vincentchen18/chess-clock/BOM.csv

Part | Qty | Unit price (USD) | Vendor | Link
HT16K33A-28SOP LED driver | 1 | 0.7531 | LCSC | https://www.lcsc.com/product-detail/C5444737.html
FJ3461AH 0.36in 4-digit 7-seg common cathode | 2 | 0.6709 | LCSC | https://www.lcsc.com/product-detail/C10708.html
100nF 0805 capacitor | 20 | 0.0206 | LCSC | https://www.lcsc.com/product-detail/C49678.html
10uF 0805 capacitor | 20 | 0.0441 | LCSC | https://www.lcsc.com/product-detail/C15850.html
PCM12SMTR slide switch | 1 | 1.2754 | LCSC | https://www.lcsc.com/product-detail/C221841.html
JST S2B-PH-SM4-TB battery connector | 5 | 0.2288 | LCSC | https://www.lcsc.com/product-detail/C295747.html
GPC12075YB-5V passive piezo buzzer | 1 | 0.5624 | LCSC | https://www.lcsc.com/product-detail/C252948.html
6x6x11mm tactile switch THT | 10 | 0.039 | LCSC | https://www.lcsc.com/product-detail/C720305.html
12x12x7.3mm tactile switch THT | 10 | 0.0662 | LCSC | https://www.lcsc.com/product-detail/C231717.html
Seeed XIAO ESP32-C3 | 1 | 0.97 | AliExpress
LiPo 503450 3.7V 1000mAh JST PH2.0 | 1 | 6.45 | AliExpress | https://www.aliexpress.com/item/1005012823920013.html
Chess clock PCB 80x95mm 2-layer | 5 | 0.80 | JLCPCB | https://jlcpcb.com
220k resistor 1/4W THT | 2 | 0.00 | Owned (resistor kit)
4.7k resistor 1/4W THT | 2 | 0.00 | Owned (resistor kit)
100 ohm resistor 1/4W THT | 1 | 0.00 | Owned (resistor kit)
