vincentchen18/chess-clock/3D Models/Printing Assembly.stl

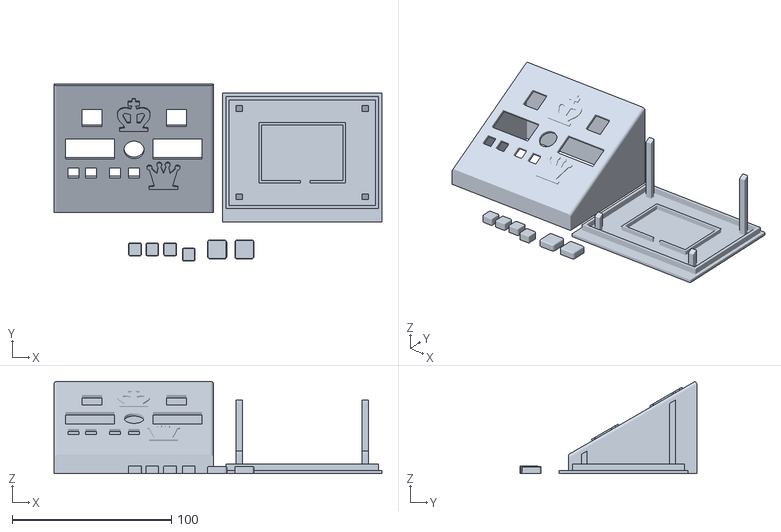
[picture p6: CAD file, 2026-10-31]
3D Models/Printing Assembly.stl
205.7 x 111.0 x 58.0
