vincentchen18/chess-clock/Kicad Files/Kicad Files.step

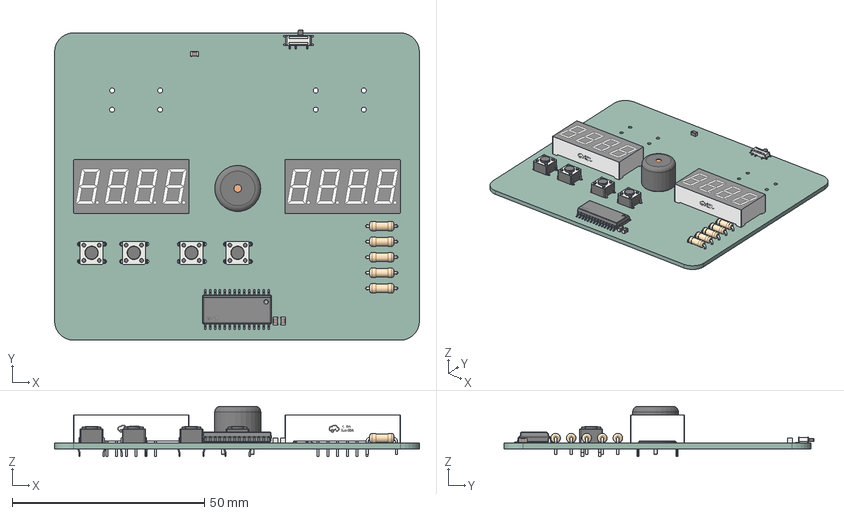
[picture p7: CAD file, 2026-10-27]
Kicad Files/Kicad Files.step
95.0 x 80.8 x 13.1 mm
R_Axial_DIN0207_L63mm_D25mm_P762mm_Horizontal x 5
Buzzer_12x95RM76
SW_PUSH_6mm x 4
C_0805_2012Metric x 3
LED-SEG-TH_0.36-4P x 2
SOP-28_L17.9-W7.5-P1.27-LS10.3-BL
Fusion_sp
Kicad Files_PCB
