vincentchen18/chess-clock/Kicad Files/Kicad Files.kicad_pcb

## KiCad design Kicad Files/Kicad Files.kicad_pcb (2026-11-01)

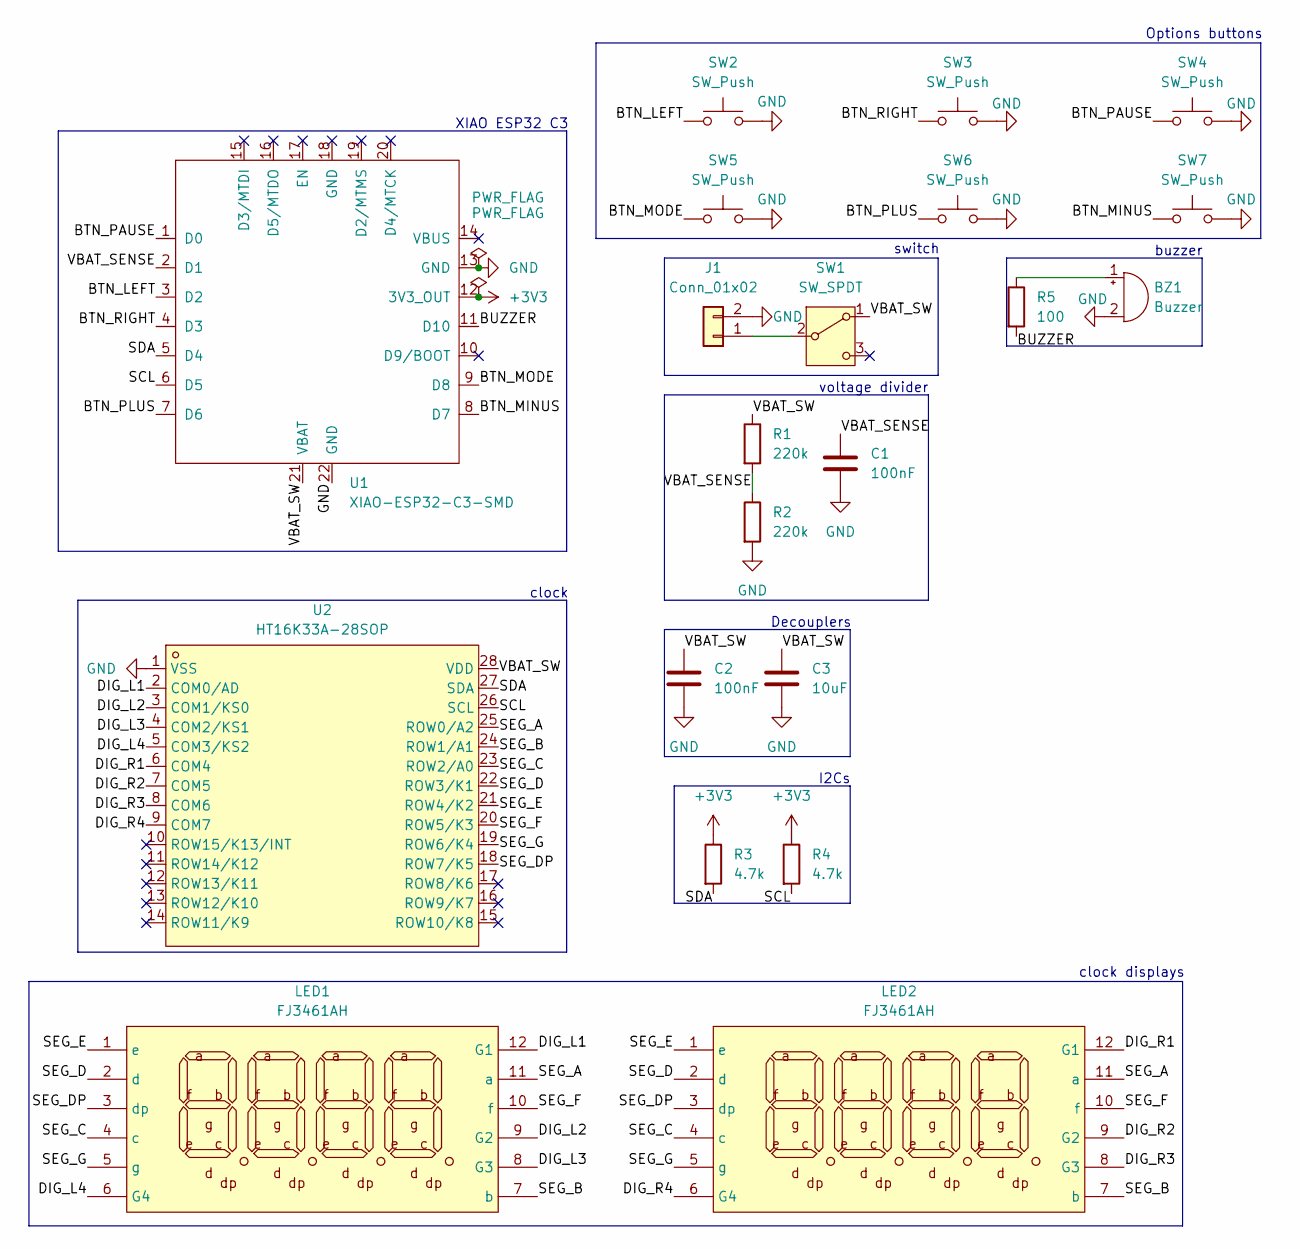
[picture p8: schematic Kicad Files.kicad_sch, chess clock :3333]

Parts:
BZ1: Buzzer; BUZ-TH_BD12.0-P6.50-D0.8-FD
C1, C2: 100nF; C_0805_2012Metric
C3: 10uF; C_0805_2012Metric
J1: Conn_01x02; JST_PH_S2B-PH-SM4-TB_1x02-1MP_P2.00mm_Horizontal
LED1, LED2: FJ3461AH; LED-SEG-TH_12P-L30.0-W14.0-P2.54-S10.16-BL; MPN FJ3461AH; LCSC Part C10708
R1, R2: 220k; R_Axial_DIN0207_L6.3mm_D2.5mm_P7.62mm_Horizontal
R3, R4: 4.7k; R_Axial_DIN0207_L6.3mm_D2.5mm_P7.62mm_Horizontal
R5: 100; R_Axial_DIN0207_L6.3mm_D2.5mm_P7.62mm_Horizontal
SW1: SW_SPDT; SW_SPDT_PCM12
SW2, SW3: SW_Push; SW_PUSH-12mm
SW4, SW5, SW6, SW7: SW_Push; SW_PUSH_6mm
U1: XIAO-ESP32-C3-SMD
U2: HT16K33A-28SOP; SOP-28_L17.9-W7.5-P1.27-LS10.3-BL; MPN HT16K33A-28SOP; LCSC Part C5444737

Connections:
+3V3: R3.1, R4.1, U1.12 (3V3_OUT)
/BTN_LEFT: SW2.1, U1.3 (D2)
/BTN_MINUS: SW7.1, U1.8 (D7)
/BTN_MODE: SW5.1, U1.9 (D8)
/BTN_PAUSE: SW4.1, U1.1 (D0)
/BTN_PLUS: SW6.1, U1.7 (D6)
/BTN_RIGHT: SW3.1, U1.4 (D3)
/BUZZER: R5.2, U1.11 (D10)
/DIG_L1: LED1.12 (G1), U2.2 (COM0/AD)
/DIG_L2: LED1.9 (G2), U2.3 (COM1/KS0)
/DIG_L3: LED1.8 (G3), U2.4 (COM2/KS1)
/DIG_L4: LED1.6 (G4), U2.5 (COM3/KS2)
/DIG_R1: LED2.12 (G1), U2.6 (COM4)
/DIG_R2: LED2.9 (G2), U2.7 (COM5)
/DIG_R3: LED2.8 (G3), U2.8 (COM6)
/DIG_R4: LED2.6 (G4), U2.9 (COM7)
/SCL: R4.2, U1.6 (D5), U2.26 (SCL)
/SDA: R3.2, U1.5 (D4), U2.27 (SDA)
/SEG_A: LED1.11 (a), LED2.11 (a), U2.25 (ROW0/A2)
/SEG_B: LED1.7 (b), LED2.7 (b), U2.24 (ROW1/A1)
/SEG_C: LED1.4 (c), LED2.4 (c), U2.23 (ROW2/A0)
/SEG_D: LED1.2 (d), LED2.2 (d), U2.22 (ROW3/K1)
/SEG_DP: LED1.3 (dp), LED2.3 (dp), U2.18 (ROW7/K5)
/SEG_E: LED1.1 (e), LED2.1 (e), U2.21 (ROW4/K2)
/SEG_F: LED1.10 (f), LED2.10 (f), U2.20 (ROW5/K3)
/SEG_G: LED1.5 (g), LED2.5 (g), U2.19 (ROW6/K4)
/VBAT_SENSE: C1.1, R1.2, R2.1, U1.2 (D1)
/VBAT_SW: C2.1, C3.1, R1.1, SW1.1 (A), U1.21 (VBAT), U2.28 (VDD)
GND: BZ1.2 (-), C1.2, C2.2, C3.2, J1.2, R2.2, SW2.2, SW3.2, SW4.2, SW5.2, SW6.2, SW7.2, U1.13 (GND), U1.22 (GND), U2.1 (VSS)
unnamed: BZ1.1 (+), R5.1
unnamed: J1.1, SW1.2 (B)

Notes on the sheet:
voltage divider
switch
Options buttons
Decouplers
clock
clock displays
I2Cs
buzzer
XIAO ESP32 C3

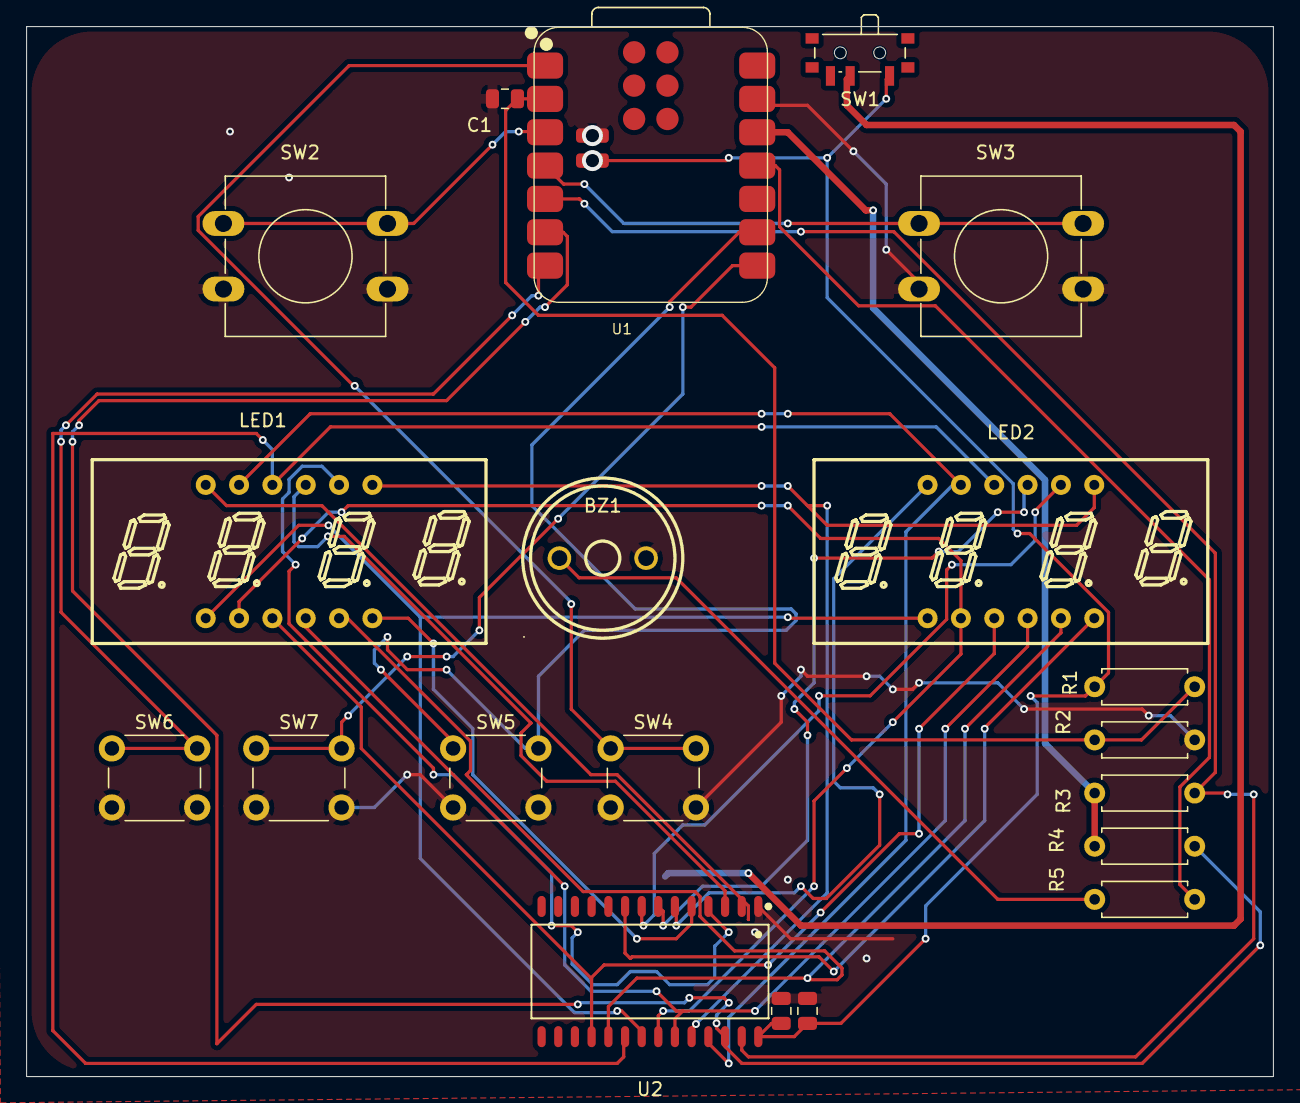
[picture p9: board Kicad Files.kicad_pcb from above]

Board: 2 copper layers, 95.0 x 80.0 mm, 21 parts (1 on the bottom side), 31 nets.
