vincentchen18/chess-clock/Journal/img.png

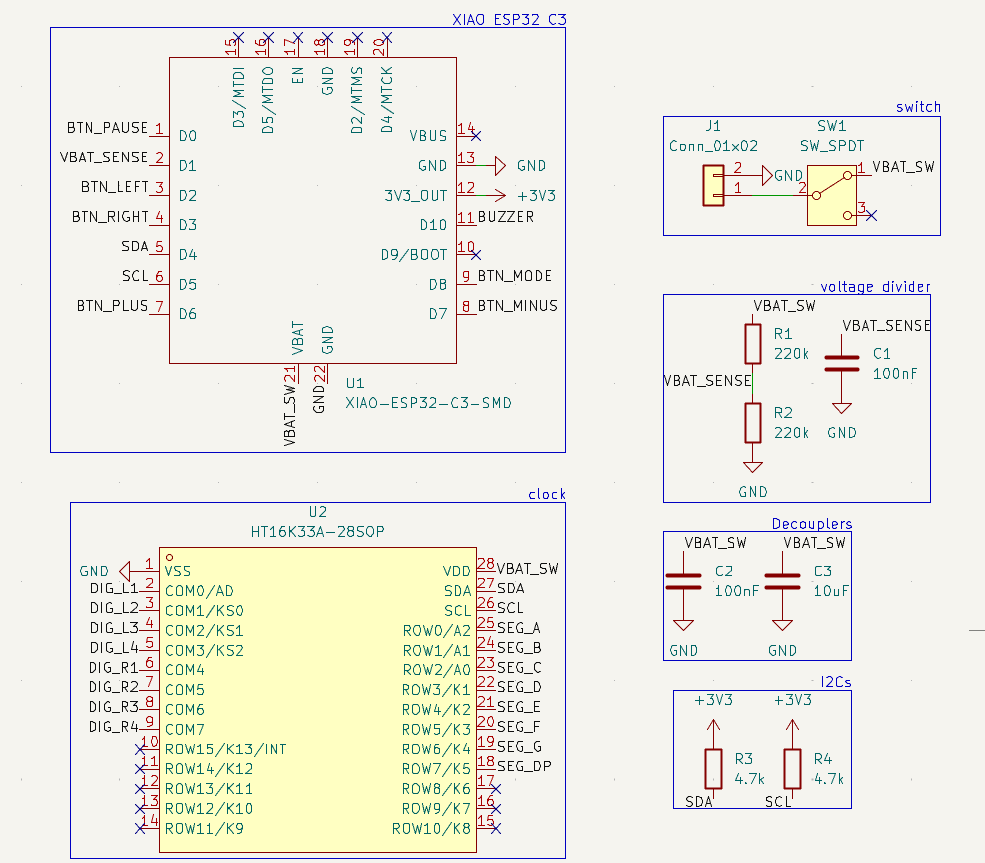
Journal/img.png
