vincentchen18/chess-clock/Journal/img_1.png

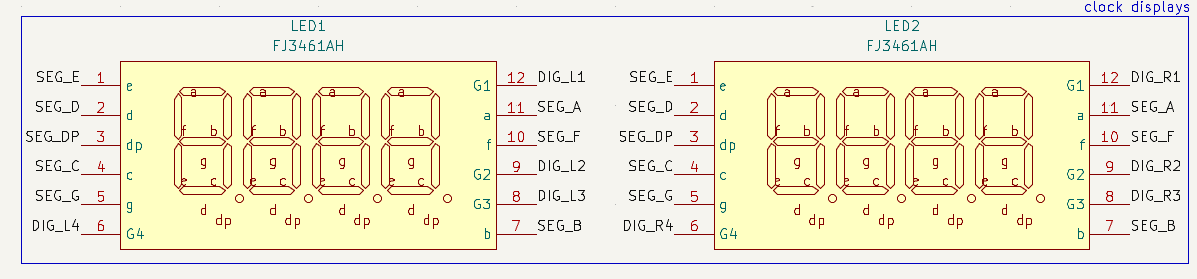
Journal/img_1.png
