vincentchen18/chess-clock/Journal/img_3.png

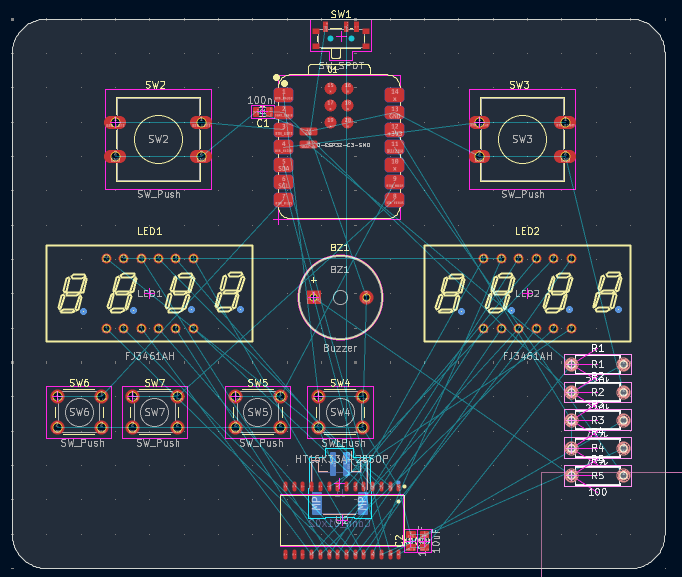
Journal/img_3.png
