vincentchen18/chess-clock/Journal/img_5.png

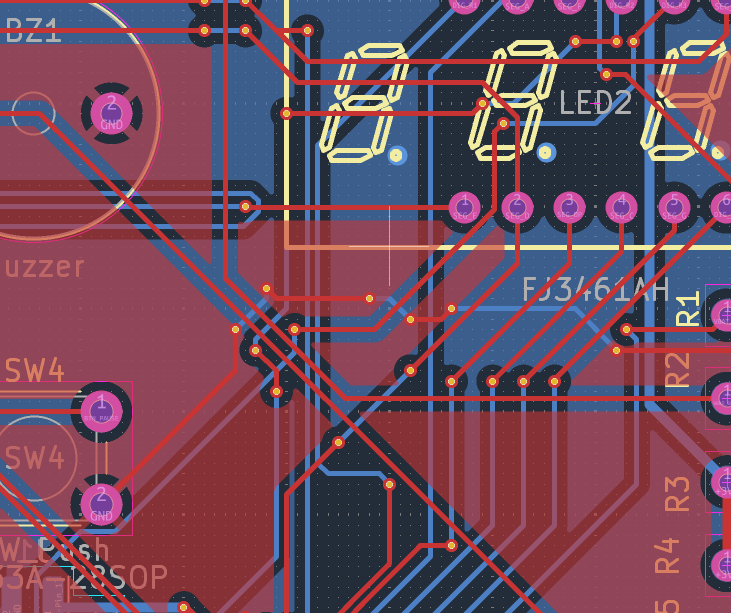
Journal/img_5.png
