vincentchen18/chess-clock/Journal/img_6.png

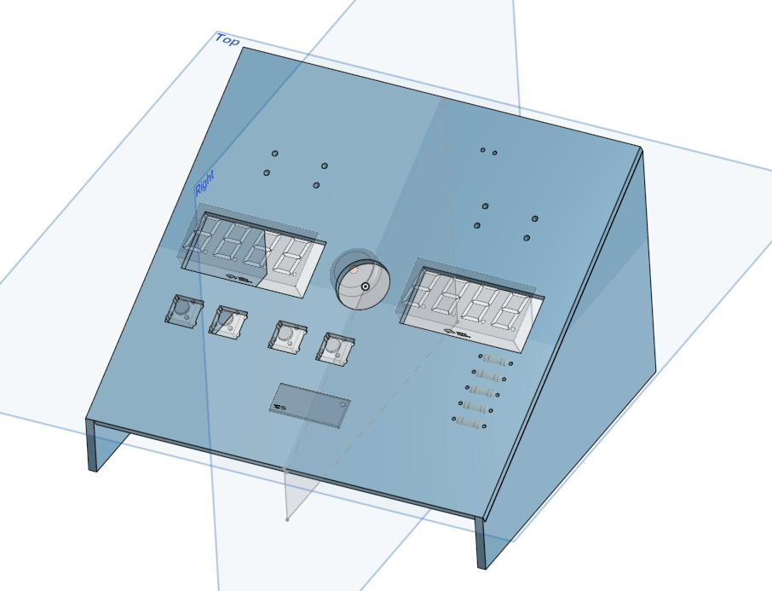
Journal/img_6.png
