vincentchen18/chess-clock/Journal/img_7.png

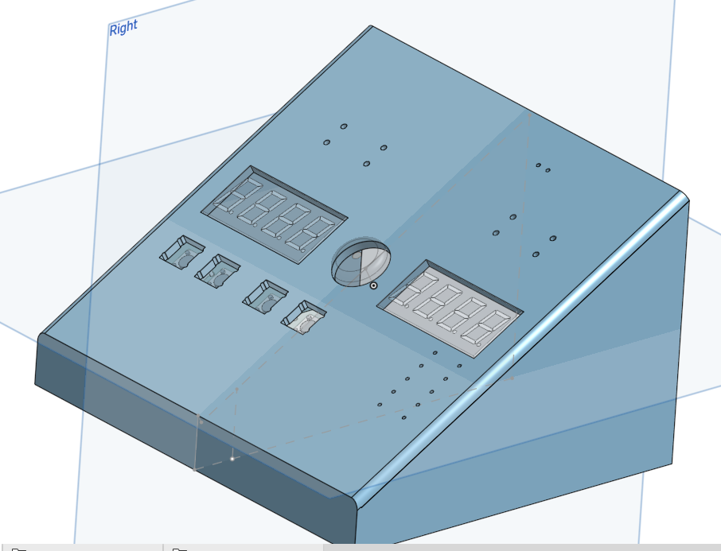
Journal/img_7.png
