vincentchen18/chess-clock/Journal/img_8.png

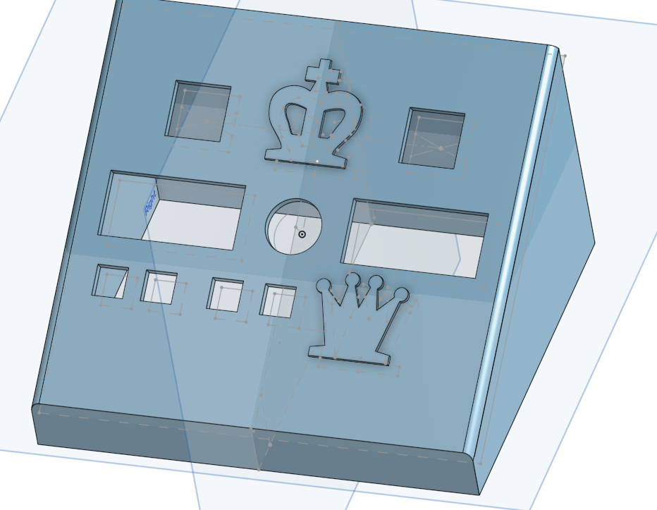
Journal/img_8.png
