vincentchen18/chess-clock/(commit log)

2026-10-26 schematica + foot print
    [Kicad Files.kicad_pcb, Kicad Files.kicad_sch]
2026-10-26 ALOT of wiring (but still barely made a dent) + pcb arrangeing
    [Kicad Files.kicad_pcb]
2026-10-26 more wirering
    [Kicad Files.kicad_pcb]
2026-10-27 finishing pcb
    [Kicad Files.kicad_pcb, Kicad Files.step]
2026-10-31 cad updates and via addition
    [Kicad Files-B_Cu.gbr, Kicad Files-B_Mask.gbr, Kicad Files-B_Paste.gbr, Kicad Files-B_Silkscreen.gbr, Kicad Files-Edge_Cuts.gbr, Kicad Files-F_Cu.gbr, Kicad Files-F_Mask.gbr, Kicad Files-F_Paste.gbr]
2026-11-01 firmware part 2: battery, clock settings, sleep, time controls
2026-11-01 update schematic for a bom part
    [Kicad Files.kicad_pcb, Kicad Files.kicad_sch]
2026-11-01 bom att 3
    [BOM.csv]
